joe3501/H520B/结构/2.png

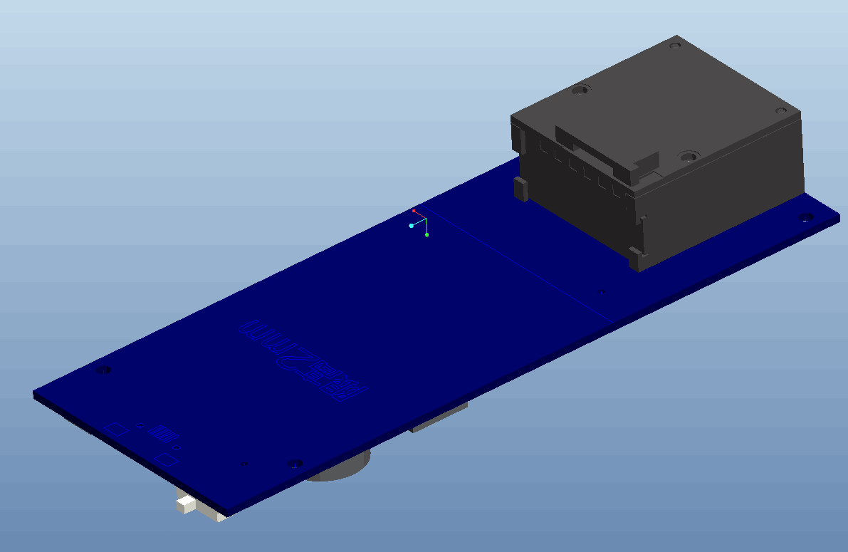
结构/2.png
