joe3501/H520B/结构/1.png

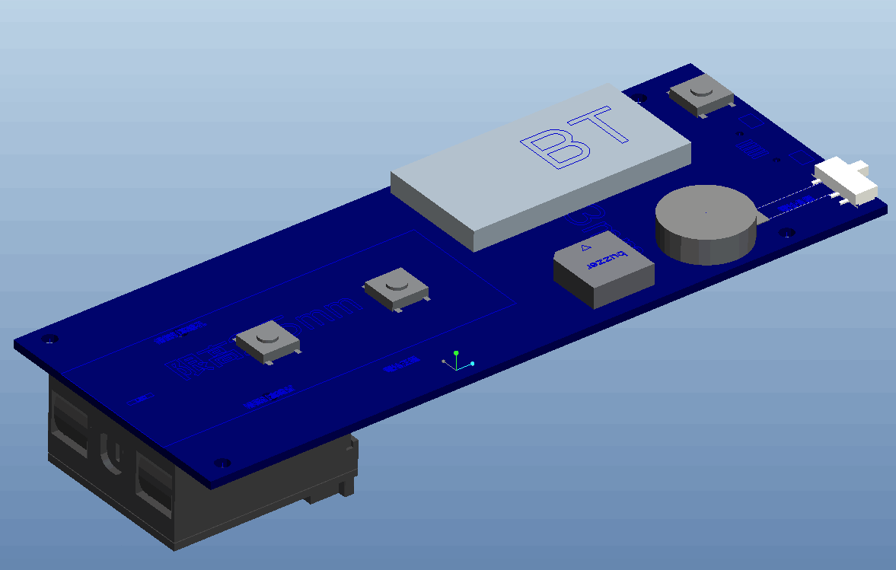
结构/1.png
