joe3501/H520B/README.md

# H520B
my handy blue tooth 1D  barcode scanner project

this project include all the data about hw、fw、结构、doc for the H520B.
