joe3501/H520B/结构/BT-PCB-151204/bt-pcb-hj5000_M3-151204.pdf

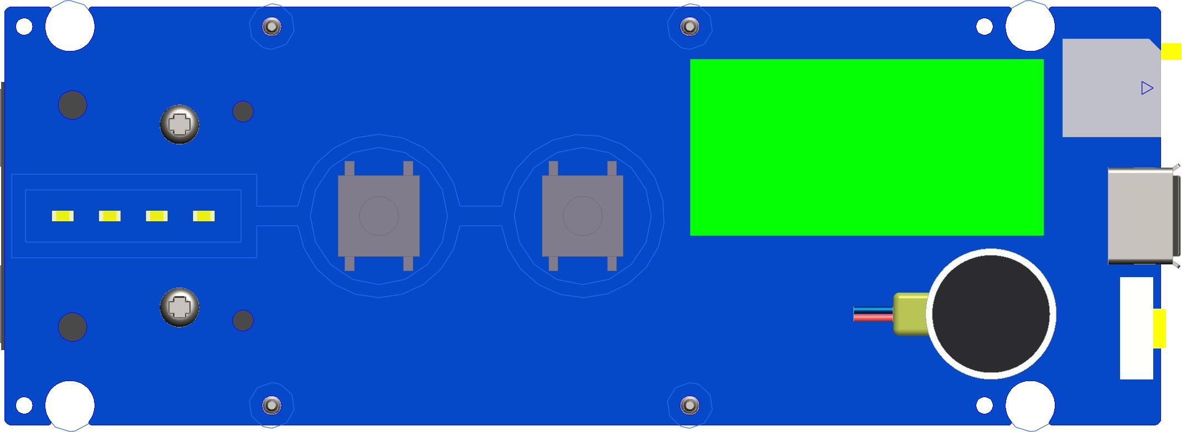
[picture p4: figure]
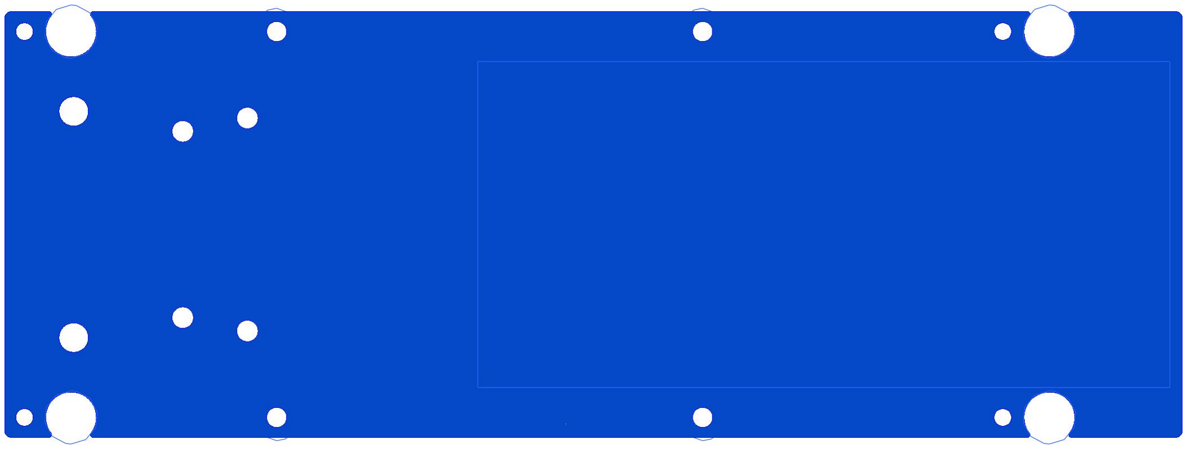
[picture p5: figure]

比例 1,000

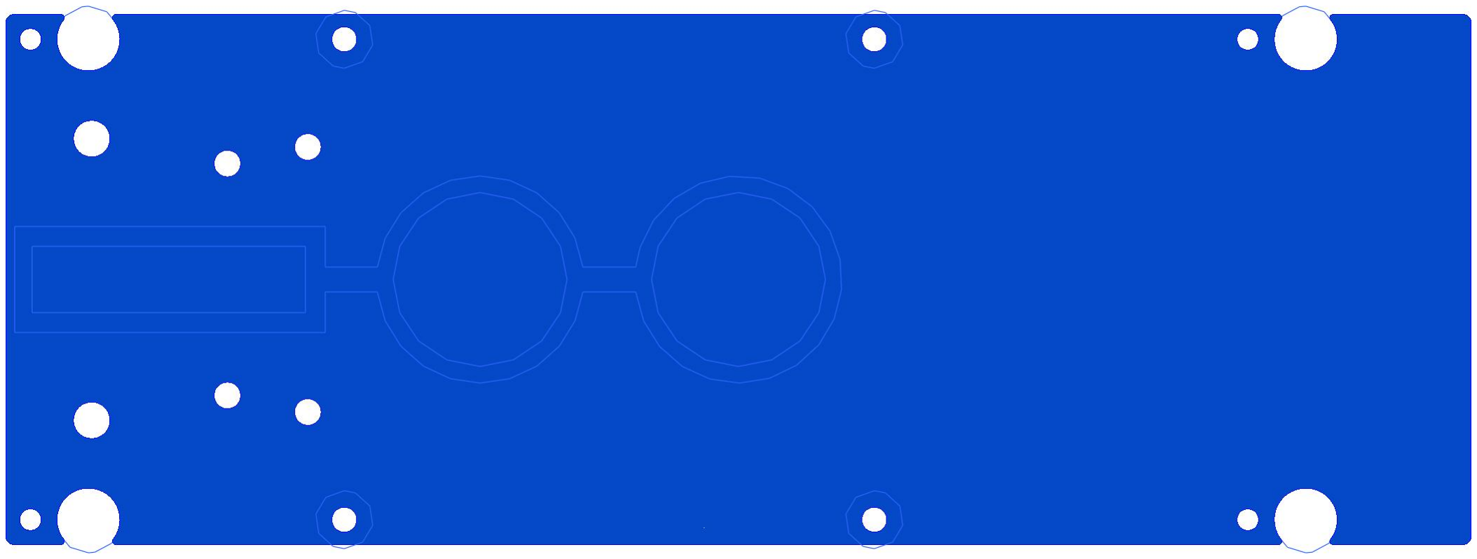
[picture p6: figure]
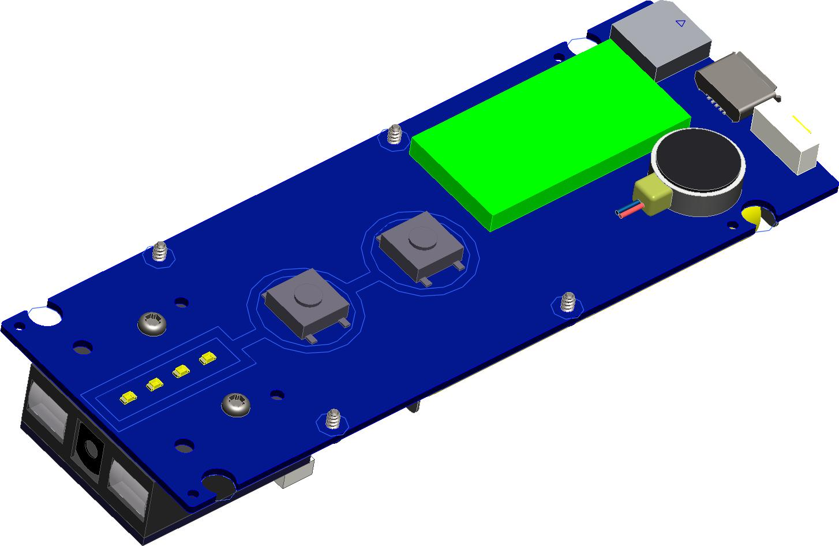
[picture p7: figure]
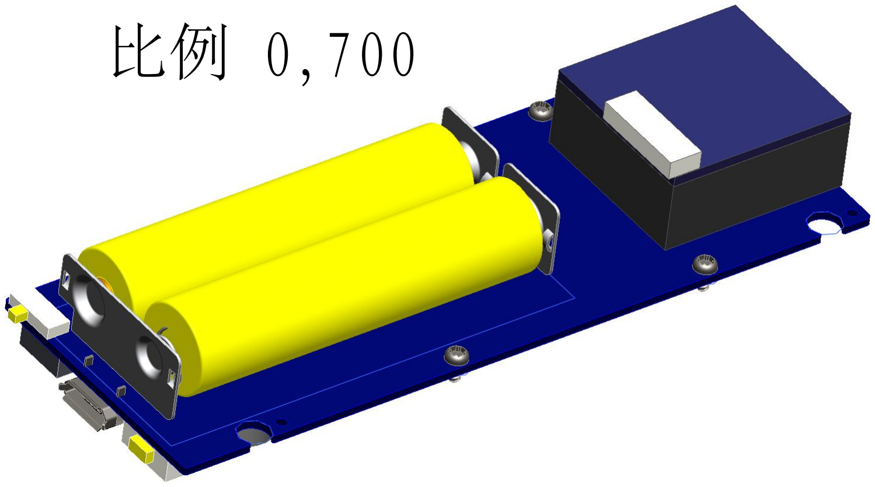
[picture p8: figure]

比例 0,700

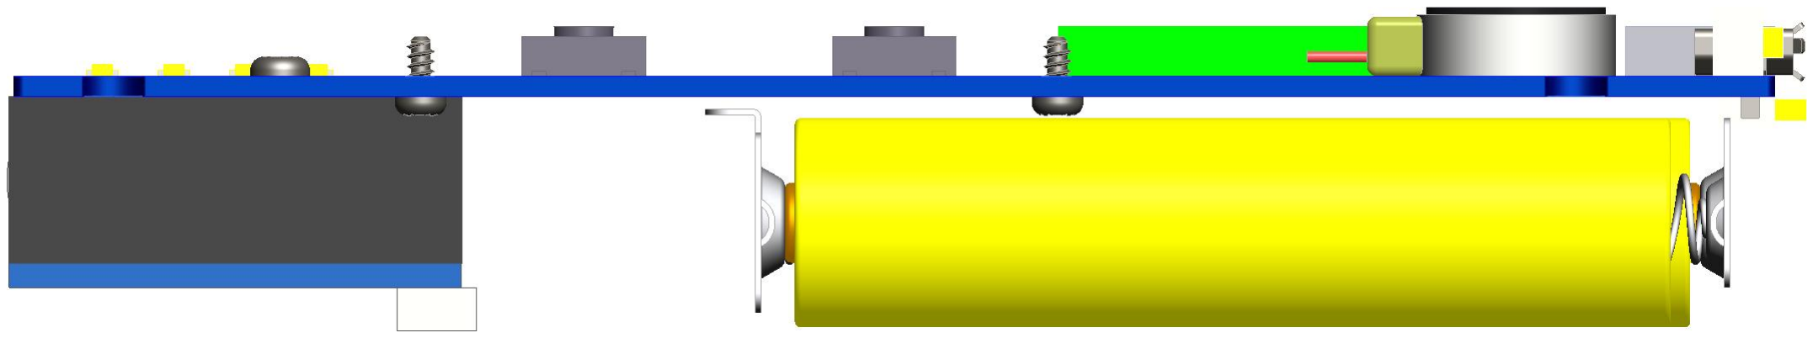
[picture p9: figure]
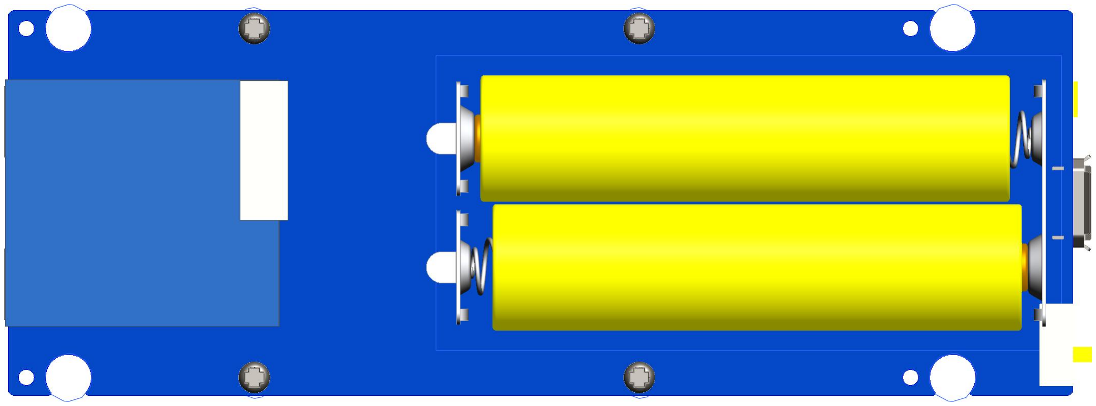
[picture p10: figure]
