joe3501/H520B/结构/BT-PCB-151204/bt-pcb-M2-151204.pdf

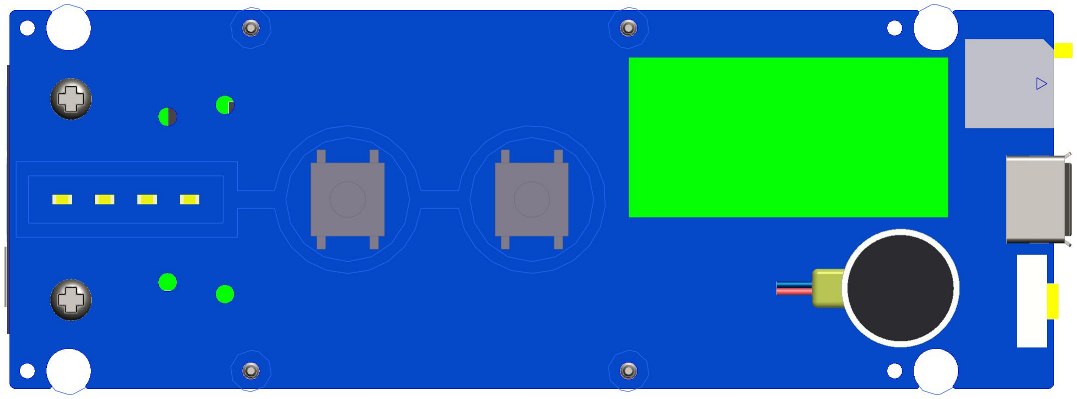
[picture p11: figure]

比例 1,000

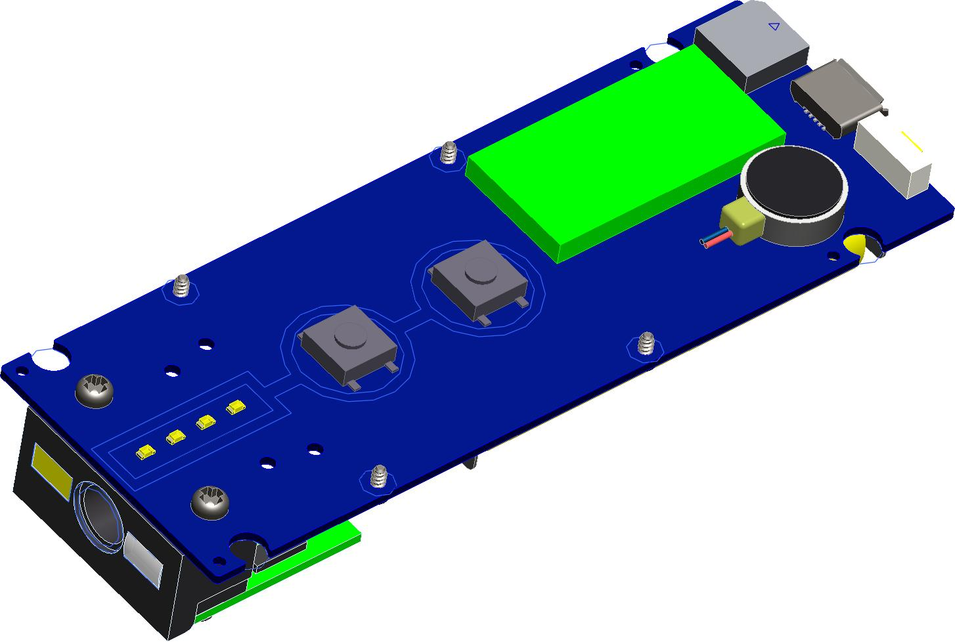
[picture p12: figure]
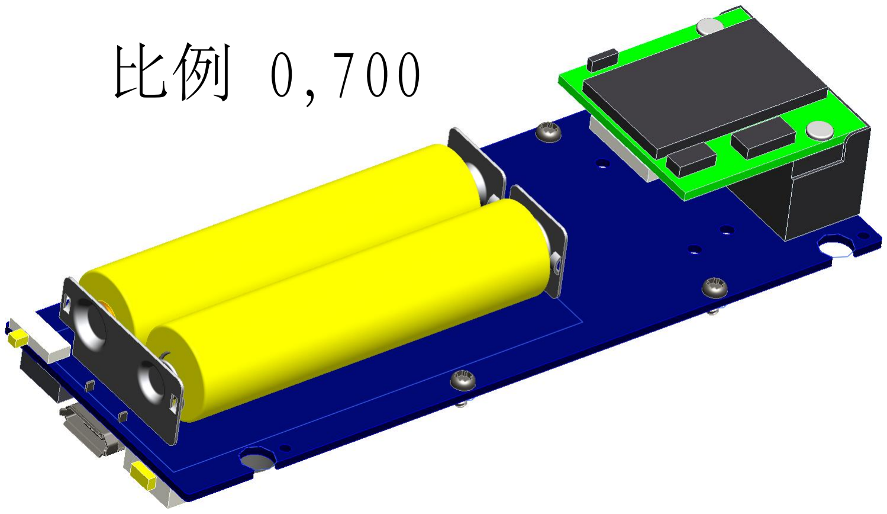
[picture p13: figure]

比例 0,700

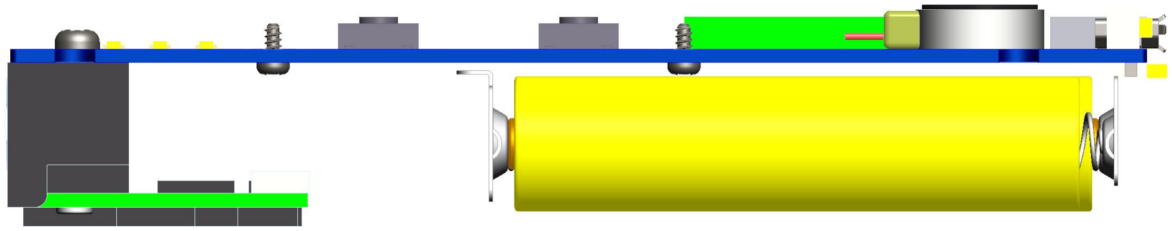
[picture p14: figure]
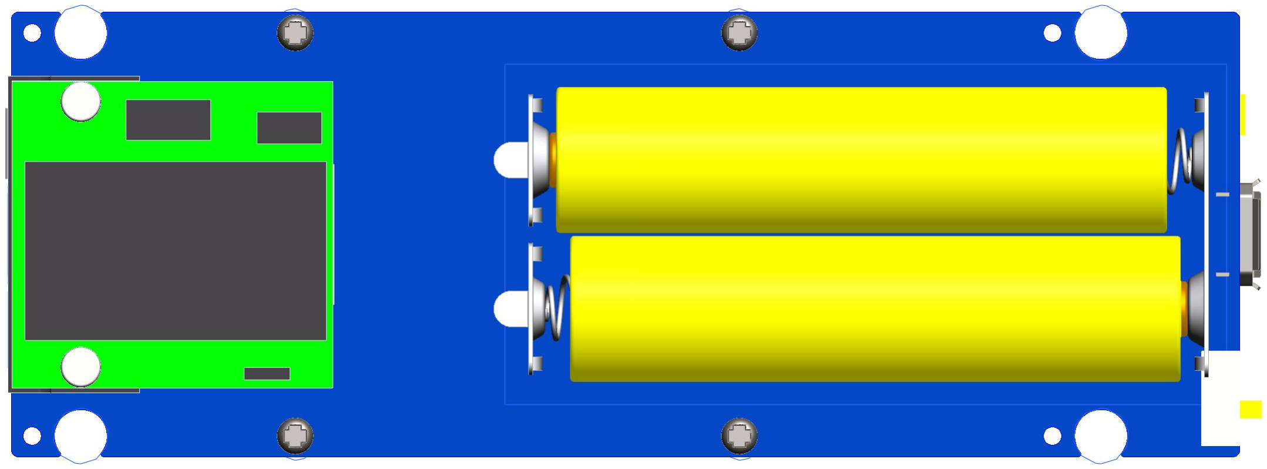
[picture p15: figure]
