joe3501/H520B/结构/BT-PCB-151204/bt-PCB-ZP-151104.pdf

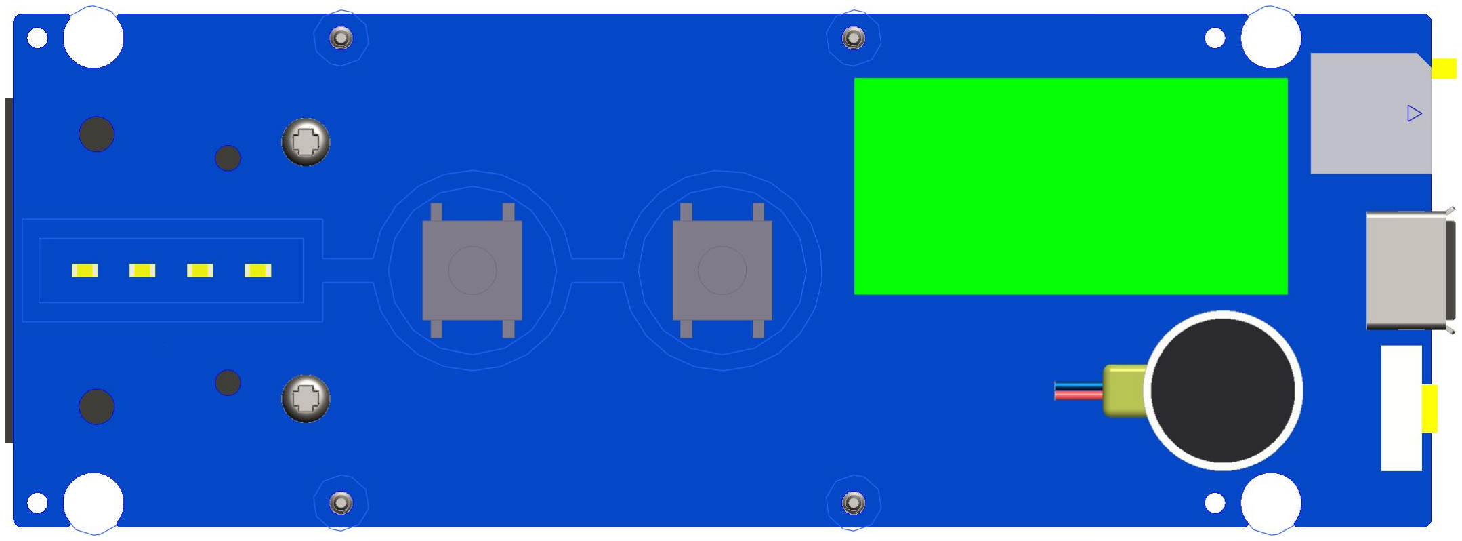
[picture p16: figure]

比例 1,000

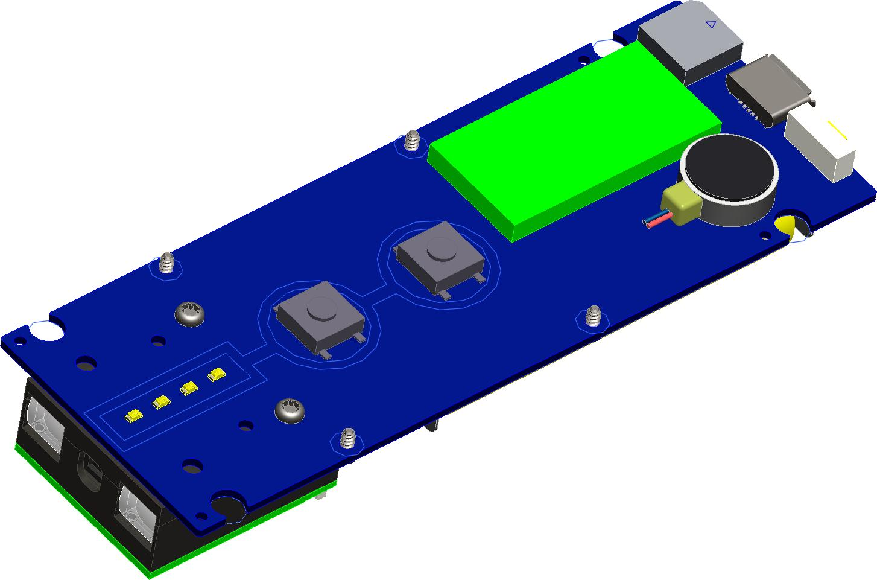
[picture p17: figure]
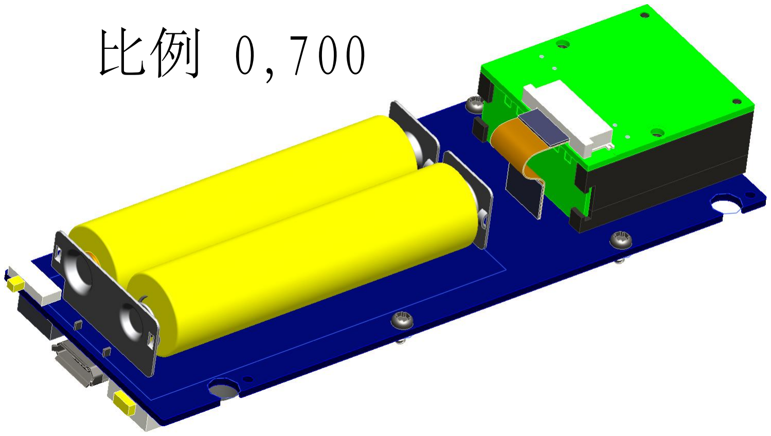
[picture p18: figure]

比例 0,700

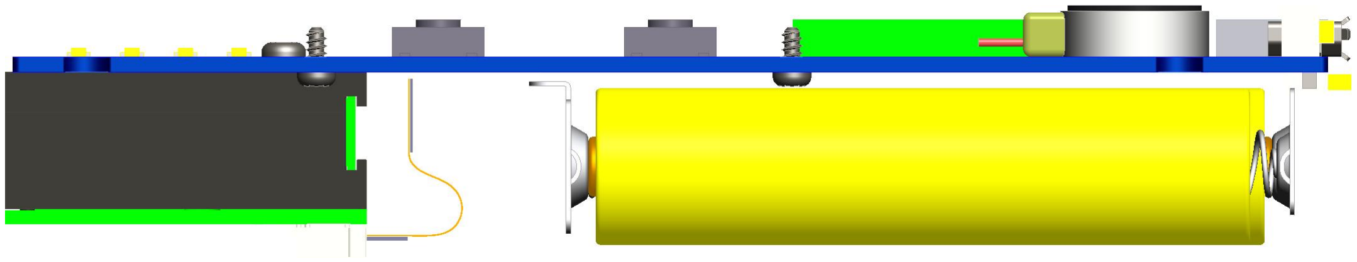
[picture p19: figure]
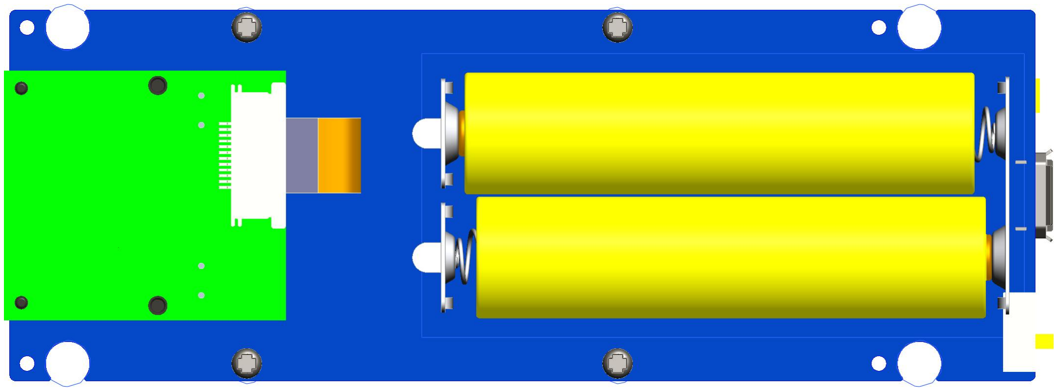
[picture p20: figure]
