joe3501/H520B/HW/data/MCBF-5S-H-R0TL4(MICRO USB).pdf

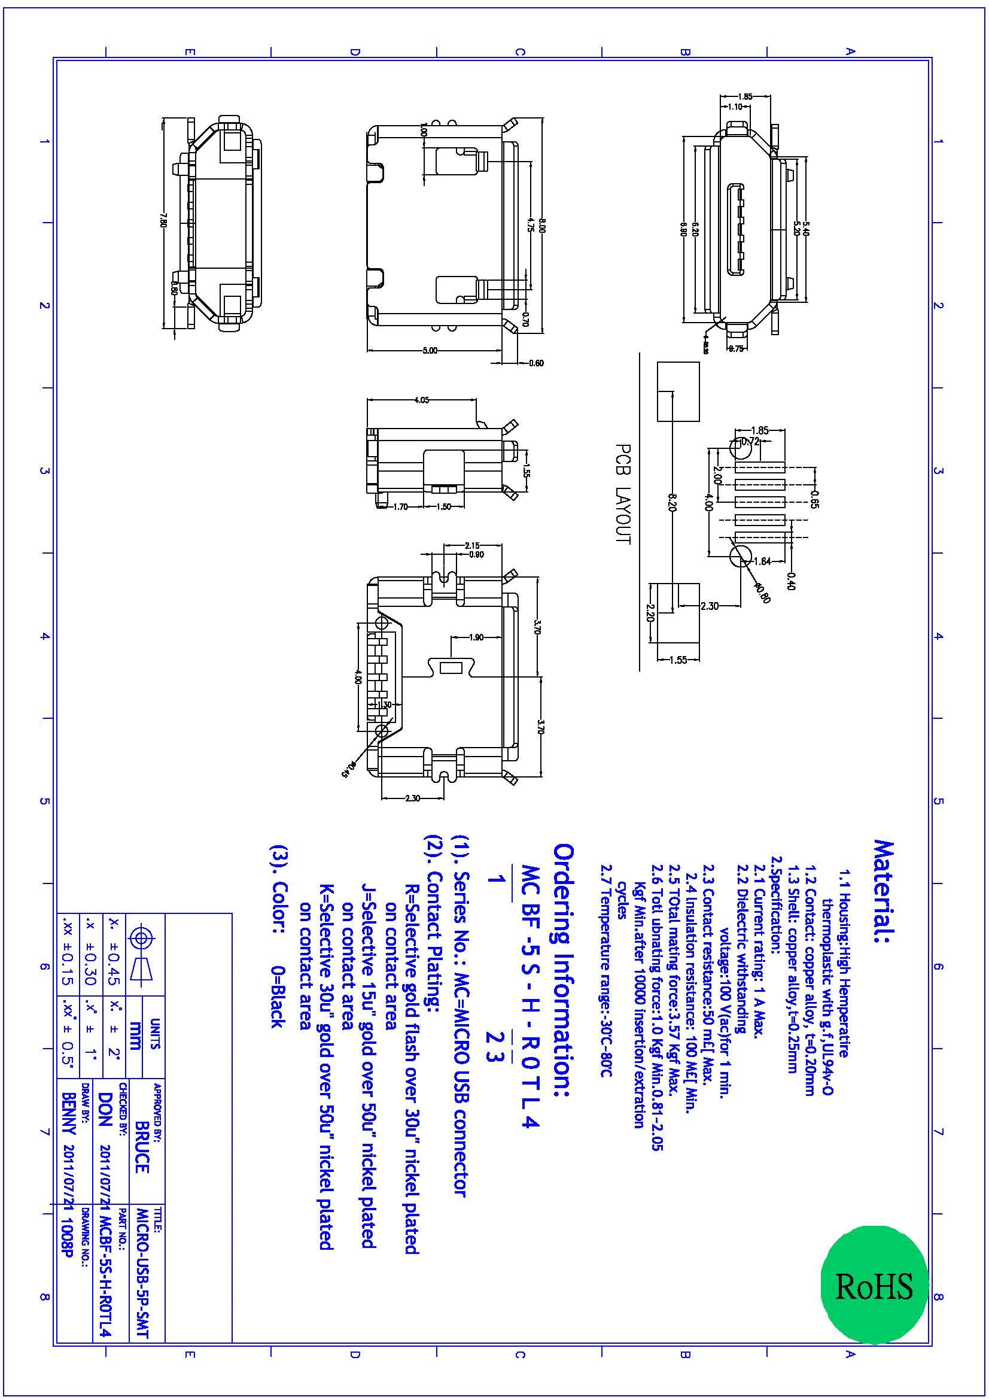
[picture p21: page 1]
