joe3501/H520B/HW/data/七脚拔动.pdf

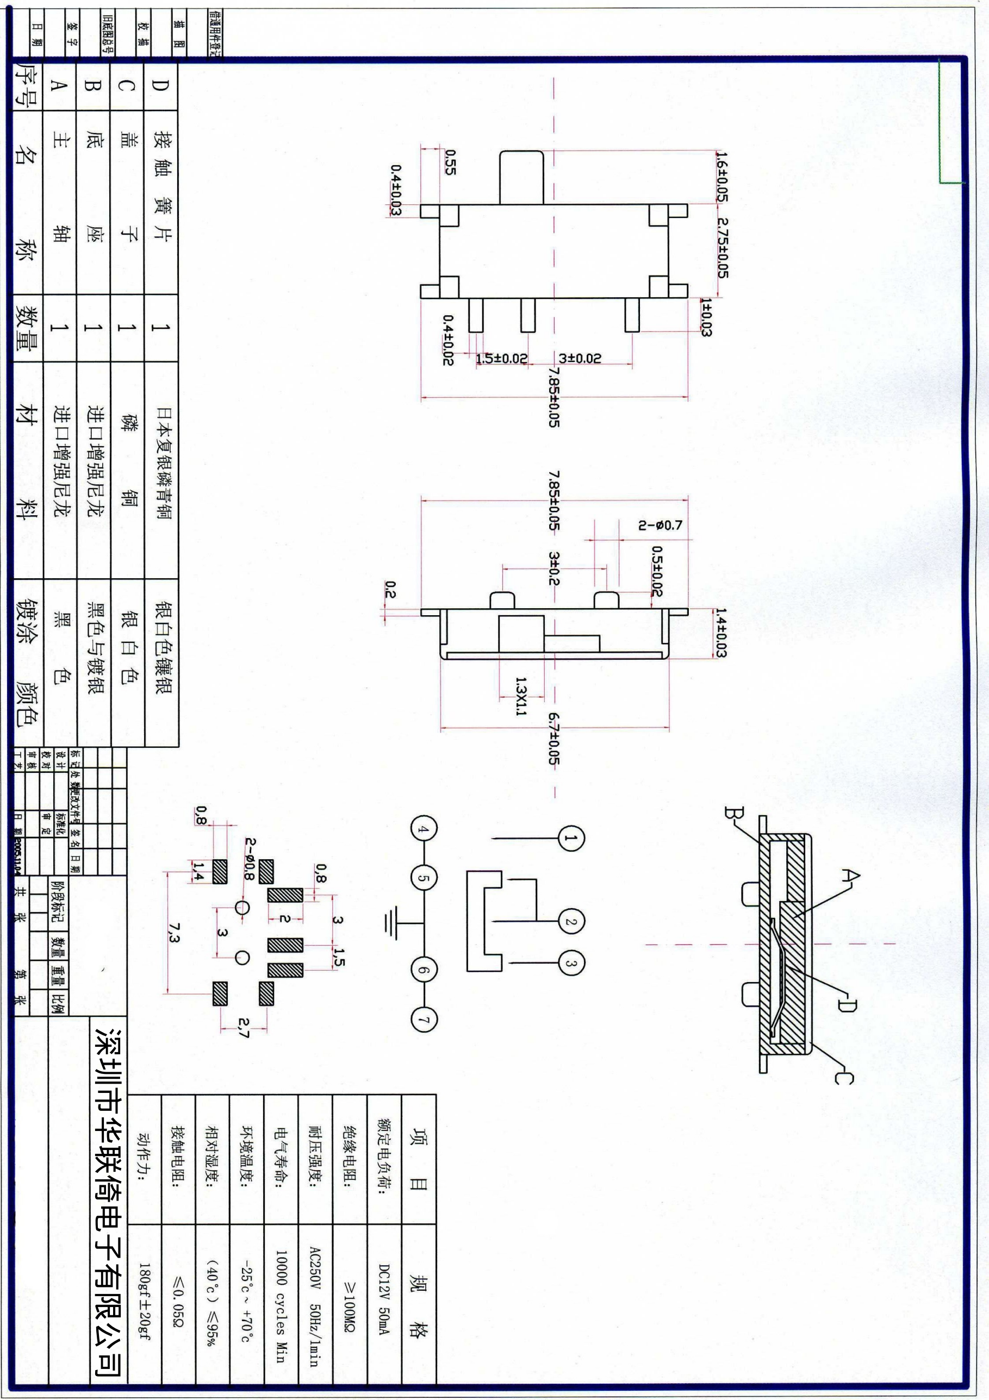
[picture p22: page 1]

深圳市华联倚电子有限公司

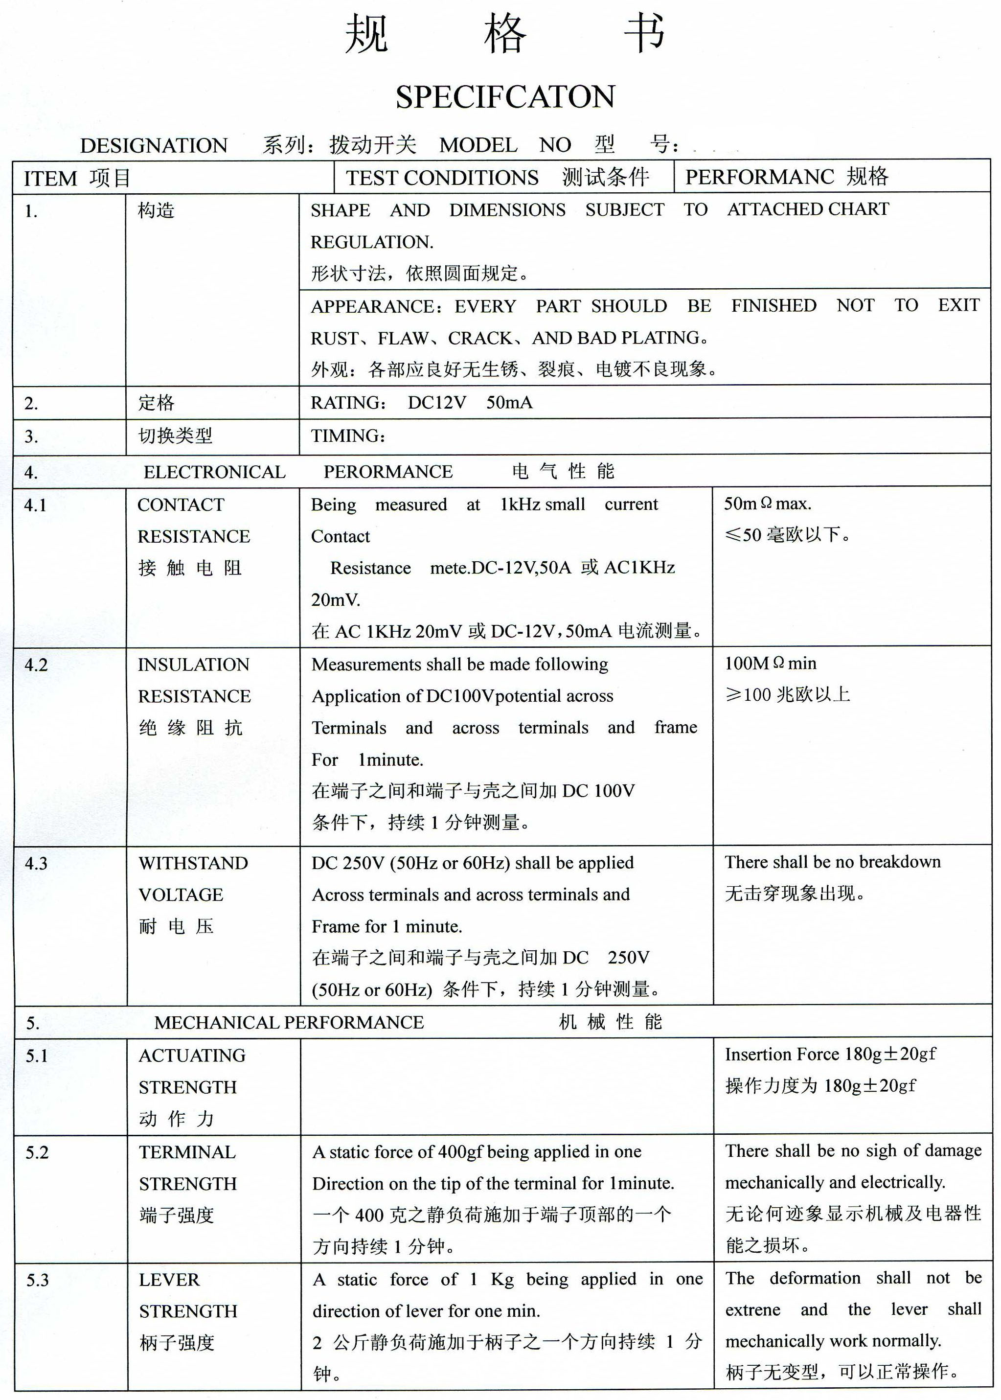
[picture p23: page 2]
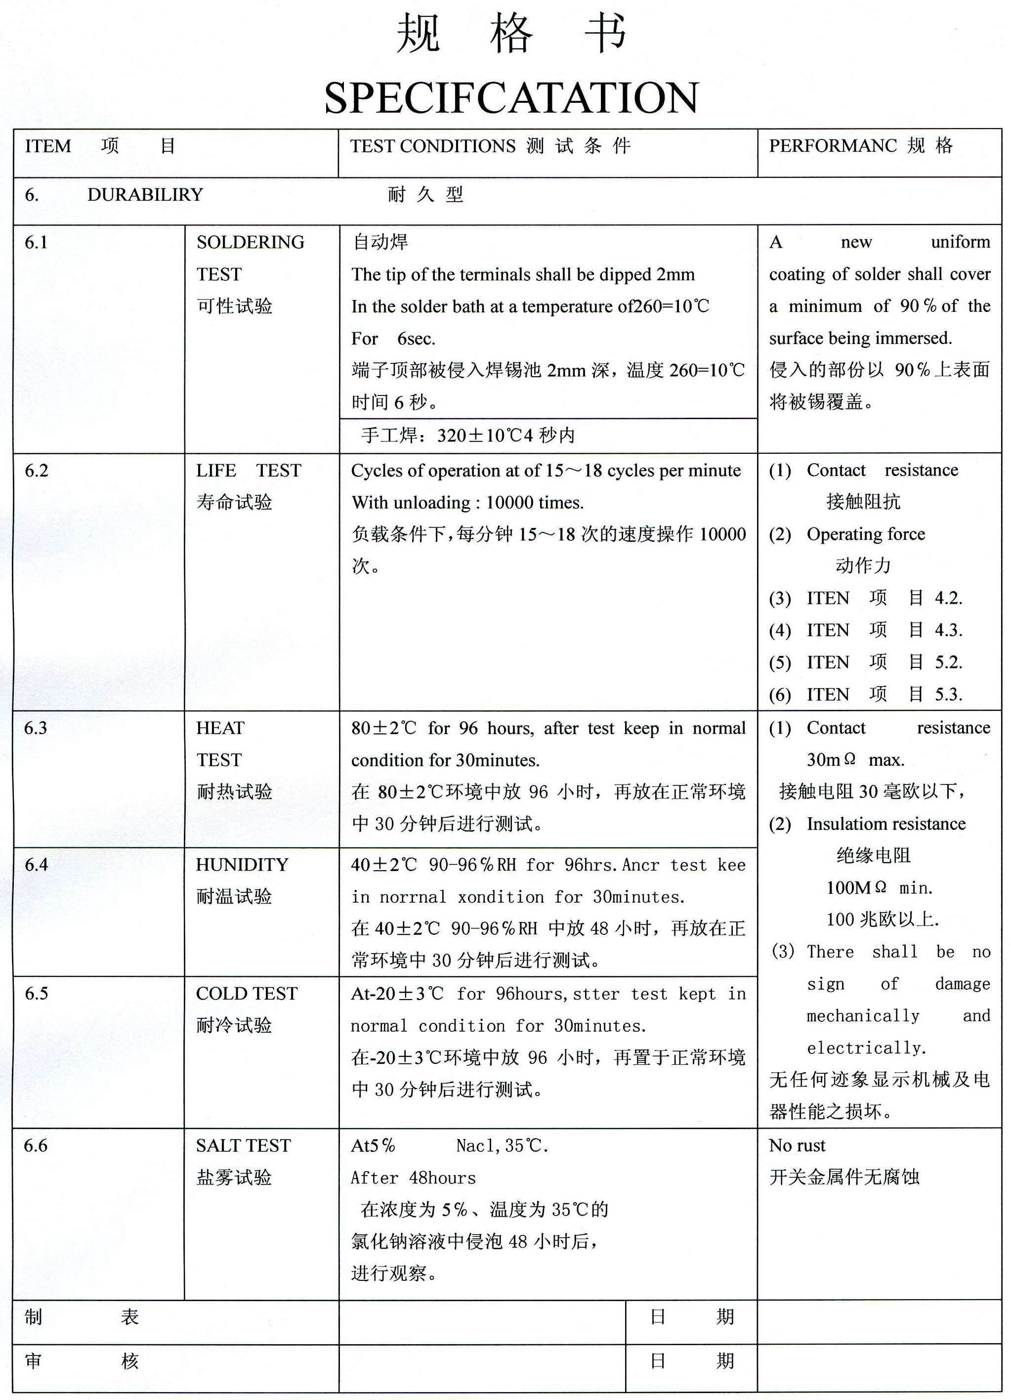
[picture p24: page 3]
