joe3501/H520B/HW/H520B Demoboard V1.0 BOM.xlsx

Part Report (BaseOption) for H520B V1.00.pcb on 2015/9/9 11:21:29
Index | Description | Value | Decal | QTY | Name
Chips |  |  |  | 6
1 | MX25L6445EM2-10G | SPI Flash | SO-8-320MIL | 1 | U3
2 | 贴片蓝牙模块 | 蓝牙模块 | WBTDS01 | 1 | U2
3 | LM324 | LM324 | SO14 | 1 | U13
4 | LS2533A | LS2533A | SOP8 | 1 | U10
5 | STM32F103C8T6 | STM32F103C8T6 | LQFP48 | 1 | U1
6 | SY7109 | SY7109 | SOT23-6 | 1 | U7
Resisters |  |  |  | 34
7 | 0mR | 0R | R0402 | 6 | R1 R8 R9 R25 R33 R36
8 | 33R | 33R | R0402 | 4 | R2 R23 R24 R31
9 | 100R | 100R | R0402 | 1 | R7
10 | 1KR | 1K | R0402 | 3 | R5 R27 R32
11 | 1.5KR | 1.5K | R0402 | 1 | R12
12 | 2.7KR | 2.7K | R0402 | 1 | R16
13 | 10KR | 10K | R0402 | 10 | R3 R4 R6 R10 R28 R29 R30 R34 R35 R39
14 | 30KR | 30K | R0402 | 1 | R11
15 | 47KR | 47K | R0402 | 2 | R19 R26
16 | 100KR | 100K | R0402 | 1 | R17
17 | 150KR | 150K | R0402 | 1 | R15
18 | 1MR | 1M | R0402 | 2 | R13 R22
19 | 2MR | 2M | R0402 | 1 | R14
Capacitors |  |  |  | 24
20 | 20pF | 20p | C0402 | 2 | C2 C19
21 | 10nF | 10nF | C0402 | 1 | C55
22 | 100nF | 0.1uF | C0402 | 7 | C17 C22 C23 C25 C42 C49 C53
23 | 100nF/10V | 0.1uF/10V | C0402 | 1 | C9
24 | 1uF | 1uF | C0402 | 3 | C3 C4 C26
25 | 1uF/10V | 1uF/10V | C0402 | 1 | C54
26 | 4.7uF | 4.7uF | C0402 | 3 | C1 C5 C21
27 | 10uF | 10uF | C0805 | 1 | C24
28 | 10uF/10V | 10uF/10V | C0805 | 2 | C8 C52
30 | 22uF/10V | 22uF/10V | C3528 | 2 | CT6 C48
31 | 47uF/10V(Tan) | 47uF/10V(Tan) | C3528 | 1 | CT3
Inductors |  |  |  | 1
32 | 4.7UH | 4.7uH | SMD_L_4X4 | 1 | L5
Diodes |  |  |  | 7
33 | 1N5819 | 1N5819 | D0603A | 3 | D1 D14 D15
34 | Blue | Blue | LED0603 | 1 | LED2
35 | Green | Green | LED0603 | 1 | LED3
36 | Red | Red | LED0603 | 1 | LED1
37 | Yellow | Yellow | LED0603 | 1 | LED4
Triodes |  |  |  | 4
38 | 3904 | 3904 | SOT23 | 3 | Q1 Q2 Q3
39 | IR6402 | IR6402 | SOT23 | 1 | Q8
Crystals |  |  |  | 1
40 | 12MHZ | 12MHZ | HSX321S-1 | 1 | Y2
Connectors |  |  |  | 9
45 | USB | USB | MICROUSB_H520B | 1 | J3
Switchs |  |  |  | 4
46 | 6脚拨动开关 | 6脚拨动开关 | 3PIN_SWITCH | 1 | SW1
47 | 轻触开关 | 轻触开关 | KEY_H520B | 3 | SW2 SW3 SW4
Unkowns |  |  |  | 6
50 | 10R 1W | 10R 1W | R0805 | 1 | R18
51 | 20K 1% | 20K 1% | R0402 | 1 | R38
52 | 30k 1% | 30k 1% | R0402 | 2 | R20 R21
53 | 91k 1% | 91k 1% | R0402 | 1 | R37
54 | 无源蜂鸣器 3.3V | 无源蜂鸣器 | BEEPER-9.0-4.0 | 1 | BEEP2
Design Part Count: 96
