joe3501/H520B/(list of files, cad)

Other CAD files:
结构/bt-PCB-150822.dwg
结构/BT-PCB-151204/bt-pcb-hj5000_M3-151204.dwg
结构/bt-PCB-150817.dwg
结构/BT-PCB-151204/bt-pcb-M2-151204.dwg
结构/bt-PCB-150803.dwg
结构/BT-PCB-151204/bt-PCB-ZP-151104.dwg
结构/bt-PCB-150821.dwg
