joe3501/H520B/HW/h520b_v100.pdf

## WBTDS01

## CON12

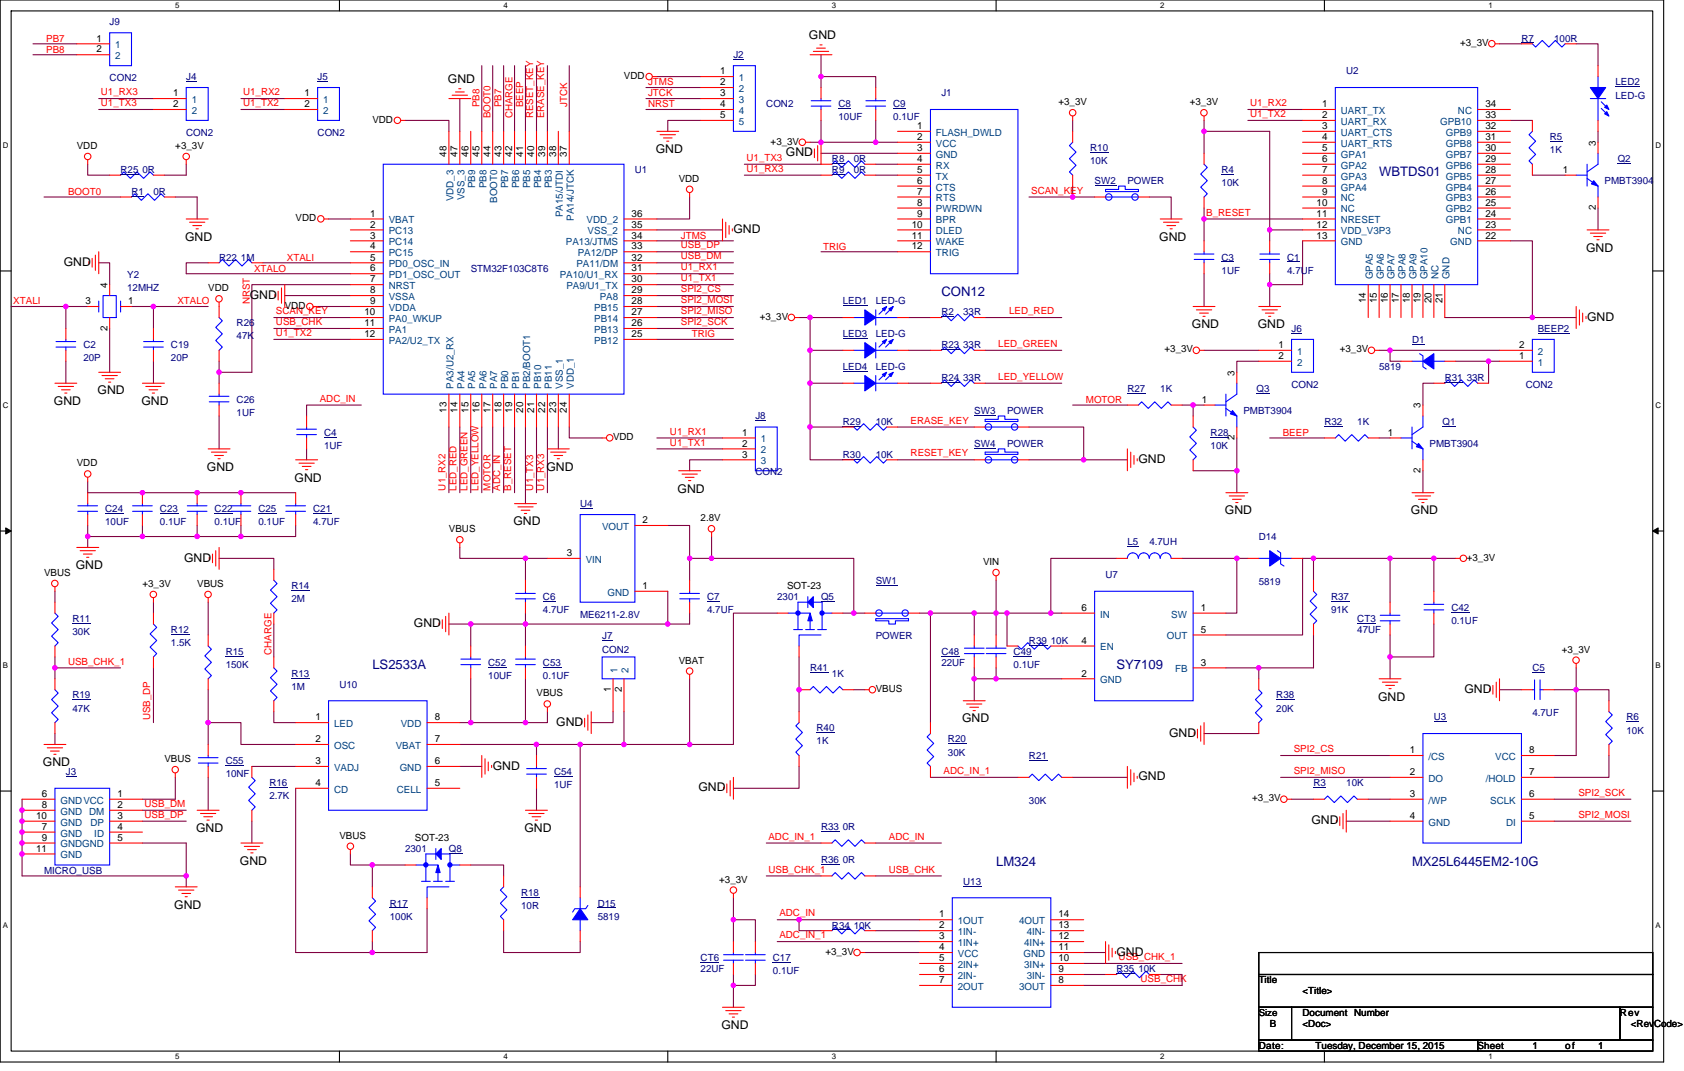
[picture p25: page 1]

Size Size Size B B B | Document Number Document Number Document Number | Rev Rev Rev

Date: Date: Date: Tuesday, December 15, 2015 Tuesday, December 15, 2015 Tuesday, December 15, 2015 | Sheet Sheet Sheet 1 1 1 of of of 1 1 1
