joe3501/H520B/HW/top-silkscreen.pdf

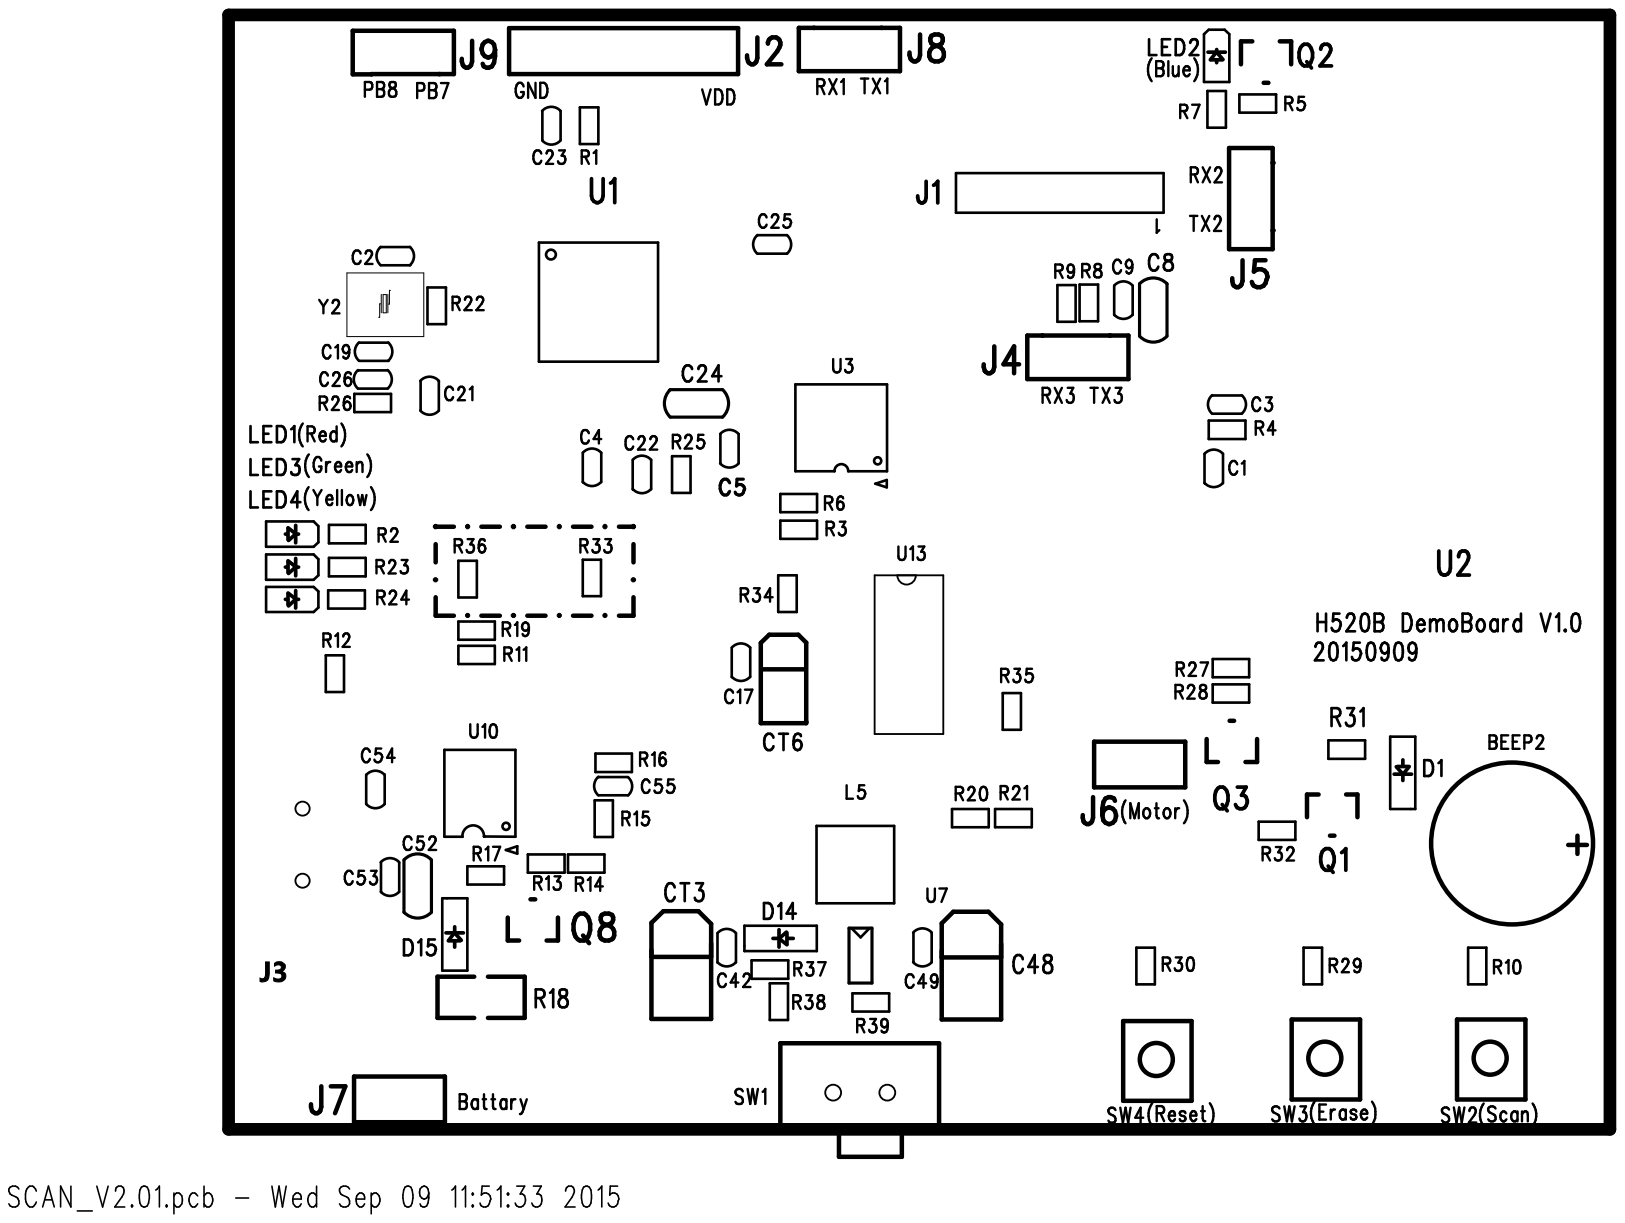
[picture p26: page 1]
