joe3501/H520B/HW/data/IT-1127-160G-G(tact sw).pdf

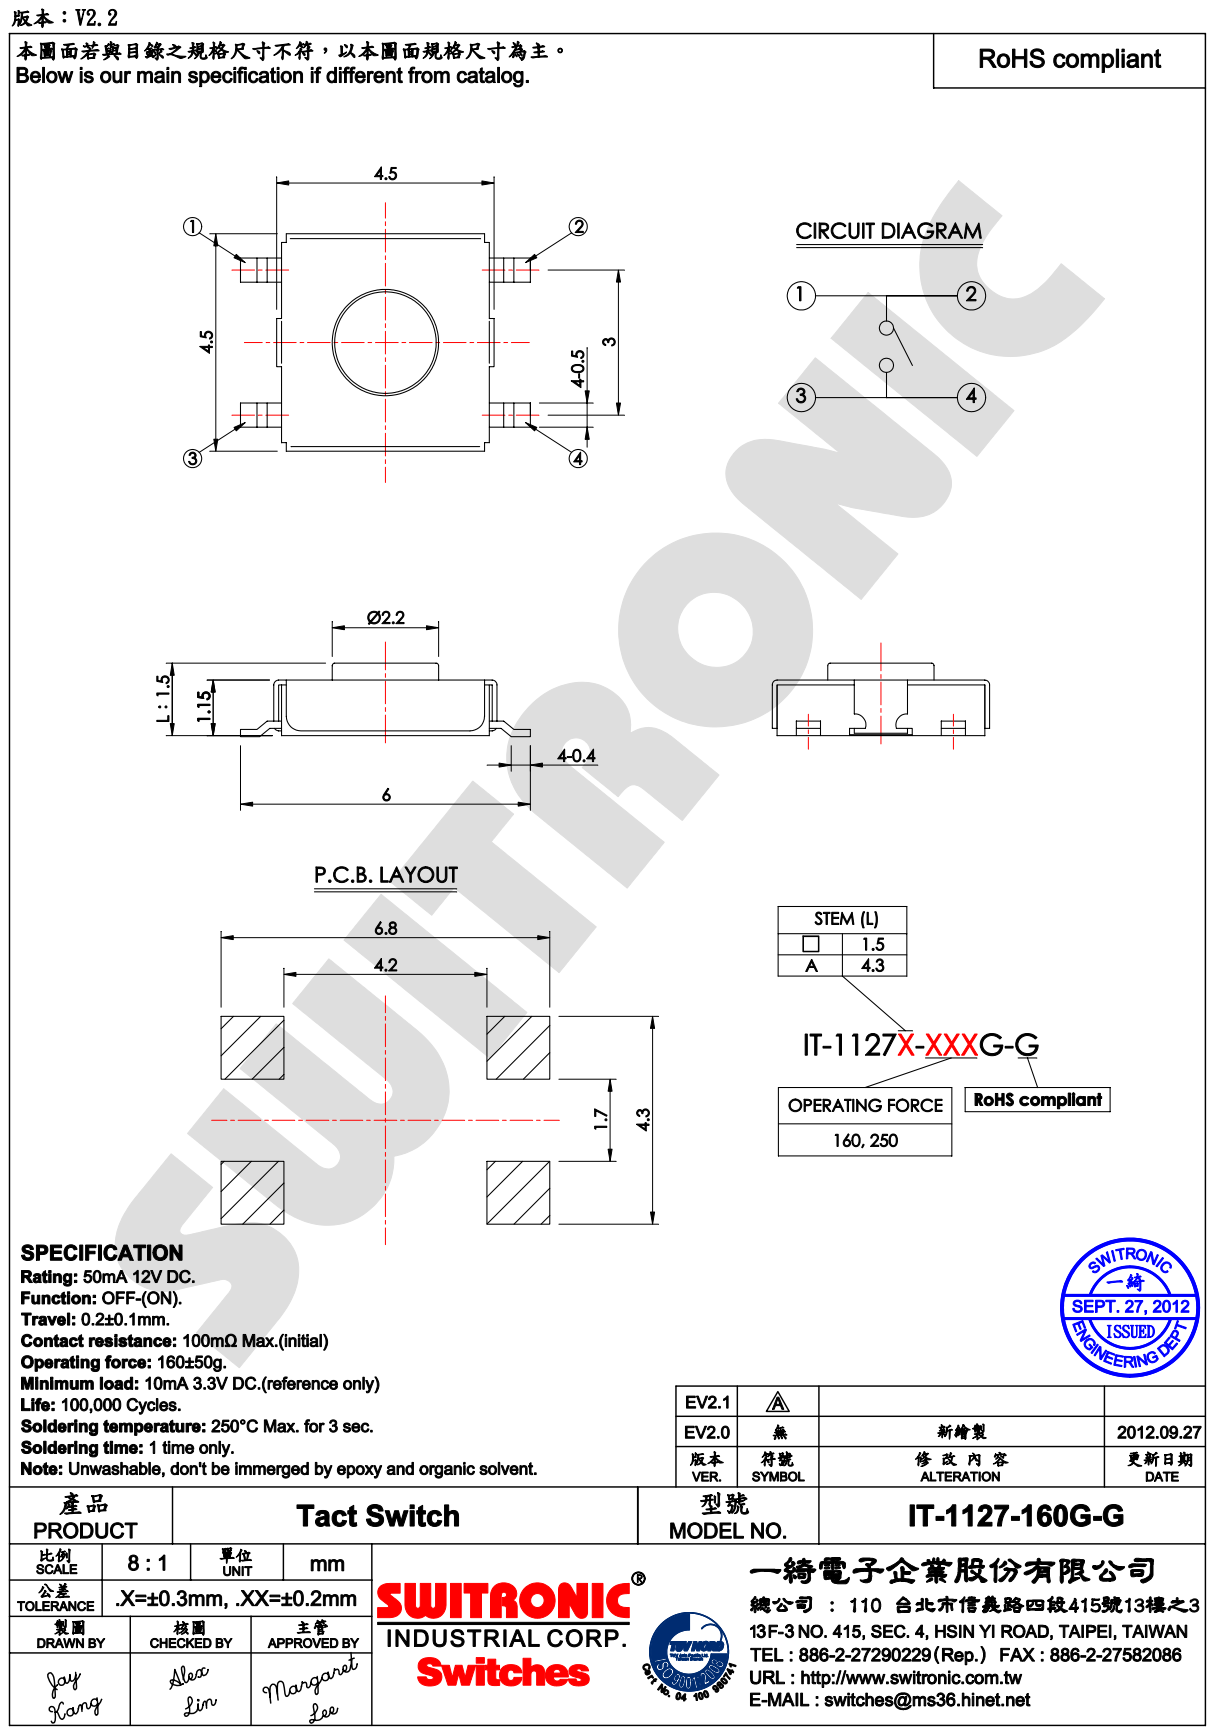
[picture p27: page 1]
