joe3501/H520B/(list of files, drawings)

Other design files:
HW/H520B V1.00.pcb
HW/H520B_V100.pcb
