joe3501/H520B/FW/src/Drivers/hw_platform.c

/**
* @file hw_platform.c
* @brief H520B 硬件相关接口的实现
* @version V0.0.1
* @author joe.zhou
* @date 2015年08月31日
* @note
* @copy
*
* 此代码为深圳合杰电子有限公司项目代码，任何人及公司未经许可不得复制传播，或用于
* 本公司以外的项目。本司保留一切追究权利。
*
* <h1><center>&copy; COPYRIGHT 2015 heroje</center></h1>
*
*/
#include "hw_platform.h"
#include "stm32f10x_lib.h"
#include "ucos_ii.h"
#include "TimeBase.h"
#include <assert.h>

static unsigned int	charge_state_cnt;
static unsigned int	last_charge_detect_io_cnt;

unsigned int	charge_detect_io_cnt;

static unsigned char	current_led_state;
static VTIMER_HANDLE	led_timer_h[4];

#define		LED_RED_MASK			(0x01<<0)
#define		LED_GREEN_MASK			(0x01<<1)
#define		LED_YELLOW_MASK			(0x01<<2)
#define		LED_BLUE_MASK			(0x01<<3)

#define		LED_RED_ON_MASK			(0x01<<4)
#define		LED_GREEN_ON_MASK		(0x01<<5)
#define		LED_YELLOW_ON_MASK		(0x01<<6)
#define		LED_BLUE_ON_MASK		(0x01<<7)

//USB_CHK		PA1	  

//LED_RED		PA4   
//LED_GREEN		PA5   
//LED_YELLOW	PA6   
//MOTOR			PA7   

//ADC_IN		PB0	  

//BEEP			PB5   
//CHARGE		PB6	  
//RFU_IO1		PB7
//RFU_IO2		PB8

//TRIG			PB12

/**
* @brief	初始化用于电池电压检测的ADC模块
* @param[in]  none
* @param[out] none
* @return     none
* @note                    
*/
static void ADC_Module_Init(void)
{
	ADC_InitTypeDef   adc_init;
	GPIO_InitTypeDef  gpio_init;


	RCC_APB2PeriphClockCmd(RCC_APB2Periph_ADC1, ENABLE);
	RCC_APB2PeriphClockCmd(RCC_APB2Periph_GPIOB, ENABLE);

	//PB.0   ADC-IN
	gpio_init.GPIO_Pin  = GPIO_Pin_0;
	gpio_init.GPIO_Speed = GPIO_Speed_50MHz;
	gpio_init.GPIO_Mode = GPIO_Mode_AIN;
	GPIO_Init(GPIOB, &gpio_init);

	adc_init.ADC_Mode               = ADC_Mode_Independent;		//
	adc_init.ADC_ScanConvMode       = DISABLE;
	adc_init.ADC_ContinuousConvMode = ENABLE;
	adc_init.ADC_ExternalTrigConv   = ADC_ExternalTrigConv_None;
	adc_init.ADC_DataAlign          = ADC_DataAlign_Right;
	adc_init.ADC_NbrOfChannel       = 1;
	ADC_Init(ADC1, &adc_init);

	ADC_RegularChannelConfig(ADC1, ADC_Channel_8, 1, ADC_SampleTime_13Cycles5);
	ADC_Cmd(ADC1, ENABLE);

	// 下面是ADC自动校准，开机后需执行一次，保证精度
	// Enable ADC1 reset calibaration register 
	ADC_ResetCalibration(ADC1);
	// Check the end of ADC1 reset calibration register
	while(ADC_GetResetCalibrationStatus(ADC1));

	// Start ADC1 calibaration
	ADC_StartCalibration(ADC1);
	// Check the end of ADC1 calibration
	while(ADC_GetCalibrationStatus(ADC1));
	// ADC自动校准结束---------------

	ADC_SoftwareStartConvCmd(ADC1, ENABLE);			//开始转换
}

/**
* @brief  Initialize the IO
* @return   none
*/
static void platform_misc_port_init(void)
{
	GPIO_InitTypeDef	GPIO_InitStructure;
	EXTI_InitTypeDef	EXTI_InitStructure;
	NVIC_InitTypeDef	NVIC_InitStructure;

	RCC_APB2PeriphClockCmd(RCC_APB2Periph_GPIOA | RCC_APB2Periph_GPIOB, ENABLE);

	//USB_CHK -- PA.1
	GPIO_InitStructure.GPIO_Pin				= GPIO_Pin_1;
	GPIO_InitStructure.GPIO_Mode			= GPIO_Mode_IN_FLOATING;
	GPIO_InitStructure.GPIO_Speed			= GPIO_Speed_10MHz;
	GPIO_Init(GPIOA, &GPIO_InitStructure);

	/* Connect EXTI Line6 to PB.6 */
	GPIO_EXTILineConfig(GPIO_PortSourceGPIOA, GPIO_PinSource1);

	EXTI_ClearITPendingBit(EXTI_Line1);
	EXTI_InitStructure.EXTI_Line = EXTI_Line1;
	EXTI_InitStructure.EXTI_Mode = EXTI_Mode_Interrupt;
	EXTI_InitStructure.EXTI_Trigger = EXTI_Trigger_Rising_Falling;
	EXTI_InitStructure.EXTI_LineCmd = ENABLE;
	EXTI_Init(&EXTI_InitStructure); 
	EXTI_GenerateSWInterrupt(EXTI_Line1);

	NVIC_PriorityGroupConfig(NVIC_PriorityGroup_1);      
	NVIC_InitStructure.NVIC_IRQChannel = EXTI1_IRQChannel;
	NVIC_InitStructure.NVIC_IRQChannelPreemptionPriority = 1;
	NVIC_InitStructure.NVIC_IRQChannelSubPriority = 6;
	NVIC_InitStructure.NVIC_IRQChannelCmd = ENABLE;
	NVIC_Init(&NVIC_InitStructure);

	//ChargeState detect -- PB.6
	GPIO_InitStructure.GPIO_Pin  = GPIO_Pin_6;
	GPIO_InitStructure.GPIO_Speed = GPIO_Speed_10MHz;
	GPIO_InitStructure.GPIO_Mode = GPIO_Mode_IN_FLOATING;
	GPIO_Init(GPIOB, &GPIO_InitStructure);

	/* Connect EXTI Line6 to PB.6 */
	GPIO_EXTILineConfig(GPIO_PortSourceGPIOE, GPIO_PinSource0);

	EXTI_ClearITPendingBit(EXTI_Line6);
	EXTI_InitStructure.EXTI_Line = EXTI_Line6;
	EXTI_InitStructure.EXTI_Mode = EXTI_Mode_Interrupt;
	EXTI_InitStructure.EXTI_Trigger = EXTI_Trigger_Rising_Falling;
	EXTI_InitStructure.EXTI_LineCmd = ENABLE;
	EXTI_Init(&EXTI_InitStructure); 
	EXTI_GenerateSWInterrupt(EXTI_Line6);

	NVIC_PriorityGroupConfig(NVIC_PriorityGroup_1);      
	NVIC_InitStructure.NVIC_IRQChannel = EXTI9_5_IRQChannel;
	NVIC_InitStructure.NVIC_IRQChannelPreemptionPriority = 1;
	NVIC_InitStructure.NVIC_IRQChannelSubPriority = 6;
	NVIC_InitStructure.NVIC_IRQChannelCmd = ENABLE;
	NVIC_Init(&NVIC_InitStructure);

	charge_detect_io_cnt = 0;
	last_charge_detect_io_cnt = 1;

	//LED-Red -- PA.4	LED-Green -- PA.5	LED-Yellow -- PA.6		Motor -- PA.7
	GPIO_InitStructure.GPIO_Pin	= GPIO_Pin_4 | GPIO_Pin_5 | GPIO_Pin_6 | GPIO_Pin_7;
	GPIO_InitStructure.GPIO_Mode = GPIO_Mode_Out_PP;
	GPIO_InitStructure.GPIO_Speed = GPIO_Speed_10MHz;
	GPIO_Init(GPIOA, &GPIO_InitStructure);
	GPIO_SetBits(GPIOA, GPIO_Pin_4 | GPIO_Pin_5 | GPIO_Pin_6);
	GPIO_ResetBits(GPIOA, GPIO_Pin_7);

	//Beep -- PB.5	LED-Blue -- PB.7
	GPIO_InitStructure.GPIO_Pin	= GPIO_Pin_5 | GPIO_Pin_7;
	GPIO_InitStructure.GPIO_Mode = GPIO_Mode_Out_PP;
	GPIO_InitStructure.GPIO_Speed = GPIO_Speed_10MHz;
	GPIO_Init(GPIOB, &GPIO_InitStructure);
	GPIO_SetBits(GPIOB,  GPIO_Pin_7);
	GPIO_ResetBits(GPIOB, GPIO_Pin_5);

	//RFU-IO2 -- PB.8		
	//GPIO_InitStructure.GPIO_Pin	= GPIO_Pin_8;
	//GPIO_InitStructure.GPIO_Mode = GPIO_Mode_IN_FLOATING;
	//GPIO_Init(GPIOB, &GPIO_InitStructure);
}

/**
* @brief  Initialize the HW platform
* @return   none
*/
void hw_platform_init(void)
{
	platform_misc_port_init();
	ADC_Module_Init();
	current_led_state = 0;
}


/**
* @brief	返回检测到的电压的级别
* @param[in]  none
* @param[out] none
* @return     0:电池电量低		1：还有电
*@note 由于电池电压经过一个MOS管Q5之后，再50%分压进入AD，而MOS管实测大概有0.375V的压降，所以当电池处于低电压阀值2.0（每节1.00V）时，实际
*		AD点的的阀值电压为1.625V/2 = 0.8125V ==>对应的AD值阀值为：1008
*/

#define  LOW_POWER_TH	1008		//	
unsigned int hw_platform_get_PowerClass(void)
{ 
#if 1
	unsigned int  i,result = 0;
	unsigned short  temp[20];
	unsigned short	min,max;

	for(i = 0;i < 20;i++)
	{
		temp[i] = ADC_GetConversionValue(ADC1);		//得到AD转换的结果
		result += temp[i];
		if (i == 0)
		{
			min = temp[i];
			max = temp[i];
		}

		if (temp[i] < min)
		{
			min = temp[i];
		}

		if (temp[i] > max)
		{
			max = temp[i];
		}
	}

	//取20次值之后,去掉最小值和最大周，再取平均值，简单的平滑滤波
	result -= min;
	result -= max;
	result /= 18; 

	if (result > LOW_POWER_TH) 
	{
		return 1;
	}
	else
		return 0;
#endif

	//return 0;
}

/**
* @brief	检测充电状态
* @param[in]  none
* @param[out] none
* @return     1:  充电完成    0: 正在充电
* @note  正在充电时，充电检测IO输出脉冲，充满后输出低电平 
*        需要注意的是：此函数只有在得知充电电源已经插入的前提下，再去检测才有意义。因为没有插入充电电源时，检测IO也是低电平的。
*		利用IO的边沿中断来完成充电状态的检测，如果一直在进中断，那说明正在充电，否则表示充电完成
*/
unsigned int  hw_platform_ChargeState_Detect(void)
{
	if (charge_detect_io_cnt != last_charge_detect_io_cnt)
	{
		charge_state_cnt = 50000;
		last_charge_detect_io_cnt = charge_detect_io_cnt;
		return 0;
	}
	else
	{
		if (charge_state_cnt--)
		{
			return 0;
		}
	}
	return 1;
}

/**
* @brief	检测USB是否插入
* @param[in]  none
* @param[out] none
* @return     1:  插入    0: 没有插入
* @note  如果需要在中断里面去实现，那么还需要在初始化时给此检测IO分配外部中断
*		 如果在任务级查询，那么可以之际调用此函数来检测是否插入充电电源                 
*/
unsigned int hw_platform_USBcable_Insert_Detect(void)
{
	unsigned int i;
	if(GPIO_ReadInputDataBit(GPIOA, GPIO_Pin_1))
	{
		for (i=0;i < 2000;i++);		//延时一小段时间，防止是因为抖动造成的
		if(GPIO_ReadInputDataBit(GPIOA,GPIO_Pin_1))
		{
			return 1;
		}
		else
		{
			return 0;
		}
	}
	else
		return 0;
}

/**
* @brief	LED控制接口
* @param[in]  unsigned int led	 LED_RED or  LED_GREEN  or LED_YELLOW
* @param[in]  unsigned int ctrl  0: close   1:open
* @return   none                 
*/
void hw_platform_led_ctrl(unsigned int led,unsigned int ctrl)
{
	if (led == LED_RED)
	{
		if (ctrl)
		{
			GPIO_ResetBits(GPIOA, GPIO_Pin_4);
		}
		else
		{
			GPIO_SetBits(GPIOA, GPIO_Pin_4);
		}
	}
	else if (led == LED_GREEN)
	{
		if (ctrl)
		{
			GPIO_ResetBits(GPIOA, GPIO_Pin_5);
		}
		else
		{
			GPIO_SetBits(GPIOA, GPIO_Pin_5);
		}
	}
	else if (led == LED_YELLOW)
	{
		if (ctrl)
		{
			GPIO_ResetBits(GPIOA, GPIO_Pin_6);
		}
		else
		{
			GPIO_SetBits(GPIOA, GPIO_Pin_6);
		}
	}
	else if (led == LED_BLUE)
	{
		if (ctrl)
		{
			GPIO_ResetBits(GPIOB, GPIO_Pin_7);
		}
		else
		{
			GPIO_SetBits(GPIOB, GPIO_Pin_7);
		}
	}
}


/**
* @brief	Motor控制接口
* @param[in]  unsigned int delay  延时一段时间,单位ms
* @return   none                 
*/
void hw_platform_motor_ctrl(unsigned short delay)
{
	GPIO_SetBits(GPIOA, GPIO_Pin_7);
	if (delay < 5)
	{
		delay_ms(delay);
	}
	else
	{
		OSTimeDlyHMSM(0,0,0,delay);
	}
	GPIO_ResetBits(GPIOA, GPIO_Pin_7);
}

/**
* @brief	Trig控制接口
* @param[in]  unsigned int delay  延时一段时间,单位ms
* @return   none                 
*/
void hw_platform_trig_ctrl(unsigned short delay)
{
	GPIO_ResetBits(GPIOB, GPIO_Pin_12);
	if (delay < 5)
	{
		delay_ms(delay);
	}
	else
	{
		OSTimeDlyHMSM(0,0,0,delay);
	}
	GPIO_SetBits(GPIOB, GPIO_Pin_12);
}

/**
* @brief	蜂鸣器简单的控制接口
* @param[in]  unsigned int delay	延时一段时间,单位ms,节拍时长
* @param[in]  unsigned int	beep_freq	蜂鸣器的发声频率，音调
* @return   none 
*/
void hw_platform_beep_ctrl(unsigned short delay,unsigned int beep_freq)
{
	int i;
	for (i = 0; i < (delay*beep_freq)/2000;i++)
	{
		GPIO_SetBits(GPIOB, GPIO_Pin_5);
		delay_us(1000000/beep_freq);
		//delay_us(100);
		GPIO_ResetBits(GPIOB, GPIO_Pin_5);
		delay_us(1000000/beep_freq);
		//delay_us(400);
	}
}

/**
* @brief	蜂鸣器与Motor同时控制接口
* @param[in]  unsigned int delay	延时一段时间,单位ms,节拍时长
* @param[in]  unsigned int	beep_freq	蜂鸣器的发声频率，音调
* @return   none 
*/
void hw_platform_beep_motor_ctrl(unsigned short delay,unsigned int beep_freq)
{
	int i;
	GPIO_SetBits(GPIOA, GPIO_Pin_7);
	for (i = 0; i < (delay*beep_freq)/2000;i++)
	{
		GPIO_SetBits(GPIOB, GPIO_Pin_5);
		delay_us(1000000/beep_freq);
		GPIO_ResetBits(GPIOB, GPIO_Pin_5);
		delay_us(1000000/beep_freq);
	}
	GPIO_ResetBits(GPIOA, GPIO_Pin_7);
}



/**
 * @brief 利用时基模块提供的定时器接口实现LED闪烁
*/
static void led_red_blink_timer_hook(void)
{
	current_led_state ^= LED_RED_MASK;
	hw_platform_led_ctrl(LED_RED,current_led_state & LED_RED_MASK);
}

static void led_blue_blink_timer_hook(void)
{
	current_led_state ^= LED_BLUE_MASK;
	hw_platform_led_ctrl(LED_BLUE,current_led_state & LED_BLUE_MASK);
}

static void led_green_blink_timer_hook(void)
{
	current_led_state ^= LED_GREEN_MASK;
	hw_platform_led_ctrl(LED_GREEN,current_led_state & LED_GREEN_MASK);
}

static void led_yellow_blink_timer_hook(void)
{
	current_led_state ^= LED_YELLOW_MASK;
	hw_platform_led_ctrl(LED_YELLOW,current_led_state & LED_YELLOW_MASK);
}

/**
 * @brief 开始LED闪烁指示
 * @param[in] unsigned int		led		
 * @param[in] unsigned short	delay	闪烁的时间间隔，也就是闪烁频率,单位10ms
 * @note 注意此接口可以让几个LED同时按照各自不同的频率闪烁
*/
void hw_platform_start_led_blink(unsigned int led,unsigned short delay)
{
	int ret;
	hw_platform_led_ctrl(led,1);
	if (led == LED_RED)
	{
		if (current_led_state & LED_RED_ON_MASK)
		{
			current_led_state |= LED_RED_MASK;
			ret = reset_timer(led_timer_h[0],V_TIMER_MODE_PERIODIC,delay*10,led_red_blink_timer_hook);
			assert(ret == 0);
		}
		else
		{
			current_led_state |= (LED_RED_MASK | LED_RED_ON_MASK);
			led_timer_h[0] = start_timer(V_TIMER_MODE_PERIODIC,delay*10,led_red_blink_timer_hook);
			assert(led_timer_h[0] != 0);
		}
	}
	else if (led == LED_BLUE)
	{
		if (current_led_state & LED_BLUE_ON_MASK)
		{
			current_led_state |= LED_BLUE_MASK;
			ret = reset_timer(led_timer_h[1],V_TIMER_MODE_PERIODIC,delay*10,led_blue_blink_timer_hook);
			assert(ret == 0);
		}
		else
		{
			current_led_state |= (LED_BLUE_MASK | LED_BLUE_ON_MASK);
			led_timer_h[1] = start_timer(V_TIMER_MODE_PERIODIC,delay*10,led_blue_blink_timer_hook);
			assert(led_timer_h[1] != 0);
		}
	}
	else if (led == LED_GREEN)
	{
		if (current_led_state & LED_GREEN_ON_MASK)
		{
			current_led_state |= LED_GREEN_MASK;
			ret = reset_timer(led_timer_h[2],V_TIMER_MODE_PERIODIC,delay*10,led_green_blink_timer_hook);
			assert(ret == 0);
		}
		else
		{
			current_led_state |= (LED_GREEN_MASK | LED_GREEN_ON_MASK);
			led_timer_h[2] = start_timer(V_TIMER_MODE_PERIODIC,delay*10,led_green_blink_timer_hook);
			assert(led_timer_h[2] != 0);
		}
	}
	else
	{
		if (current_led_state & LED_YELLOW_ON_MASK)
		{
			current_led_state |= LED_YELLOW_MASK;
			ret = reset_timer(led_timer_h[3],V_TIMER_MODE_PERIODIC,delay*10,led_yellow_blink_timer_hook);
			assert(ret == 0);
		}
		else
		{
			current_led_state |= (LED_YELLOW_MASK | LED_YELLOW_ON_MASK);
			led_timer_h[3] = start_timer(V_TIMER_MODE_PERIODIC,delay*10,led_yellow_blink_timer_hook);
			assert(led_timer_h[3] != 0);
		}
	}
}

/**
 * @brief 关闭某一个在闪烁的LED
*/
void hw_platform_stop_led_blink(unsigned int led)
{
	int ret;
	if (led == LED_RED)
	{
		hw_platform_led_ctrl(LED_RED,0);
		if (current_led_state & LED_RED_ON_MASK)
		{
			current_led_state &= ~LED_RED_MASK;
			current_led_state &= ~LED_RED_ON_MASK;
			ret = stop_timer(led_timer_h[0]);
			assert(ret == 0);
		}
	}
	else if (led == LED_BLUE)
	{
		hw_platform_led_ctrl(LED_BLUE,0);
		if (current_led_state & LED_BLUE_ON_MASK)
		{
			current_led_state &= ~LED_BLUE_MASK;
			current_led_state &= ~LED_BLUE_ON_MASK;
			ret = stop_timer(led_timer_h[1]);
			assert(ret == 0);
		}
	}
	else if (led == LED_GREEN)
	{
		hw_platform_led_ctrl(LED_GREEN,0);
		if (current_led_state & LED_GREEN_ON_MASK)
		{
			current_led_state &= ~LED_GREEN_MASK;
			current_led_state &= ~LED_GREEN_ON_MASK;
			ret = stop_timer(led_timer_h[2]);
			assert(ret == 0);
		}
	}
	else
	{
		hw_platform_led_ctrl(LED_YELLOW,0);
		if (current_led_state & LED_YELLOW_ON_MASK)
		{
			current_led_state &= ~LED_YELLOW_MASK;
			current_led_state &= ~LED_YELLOW_ON_MASK;
			ret = stop_timer(led_timer_h[3]);
			assert(ret == 0);
		}
	}
}

/**
 * @brief 调试IO
*/
void hw_platform_trip_io(void)
{
	GPIO_ResetBits(GPIOB, GPIO_Pin_8);
	GPIO_SetBits(GPIOB, GPIO_Pin_8);
}


//测试LED的闪烁接口
void hw_platform_led_blink_test(void)
{
	hw_platform_start_led_blink(LED_RED,6);
	OSTimeDlyHMSM(0,0,10,0);
	hw_platform_start_led_blink(LED_BLUE,20);
	OSTimeDlyHMSM(0,0,10,0);
	hw_platform_start_led_blink(LED_GREEN,50);
	OSTimeDlyHMSM(0,0,10,0);
	hw_platform_start_led_blink(LED_YELLOW,300);

	OSTimeDlyHMSM(0,0,10,0);

	hw_platform_stop_led_blink(LED_RED);

	OSTimeDlyHMSM(0,0,10,0);

	hw_platform_stop_led_blink(LED_BLUE);

	OSTimeDlyHMSM(0,0,10,0);

	hw_platform_stop_led_blink(LED_GREEN);

	OSTimeDlyHMSM(0,0,10,0);

	StartDelay(5000);

	while (DelayIsEnd()==0);

	hw_platform_stop_led_blink(LED_YELLOW);

}
