joe3501/H520B/(commit log)

2015-08-26 hthe first commit to the master
    [H520B V1.00.pcb, H520B V1.00.sch, bt-PCB-150803.dwg, bt-PCB-150817.dwg, bt-PCB-150821.dwg, bt-PCB-150822.dwg]
2015-08-27 add a document Doc/BT Pocket功能说明.doc
2015-09-09 add demoboard sch and pcb layout
    [H520B Demoboard V1.0 BOM.xlsx, H520B V1.00.pcb, H520B V1.00.sch]
2015-09-15 add a new bsp drivers and fix so much bugs
    [HJ5000_scanner.c, hw_platform.c, hw_platform.h, keypad.c, keypad.h]
2015-09-19 Scanner driver ok! WBTDS01 driver NG!
2015-09-23 BT HID mode OK ,USB HID mode OK, soft timer list todo...!
2015-09-25 almost ok,but the lowpower mode bug need to fix!
    [Terminal_Para.c, Terminal_Para.h, app.c, hw_platform.c, hw_platform.h, keypad.c]
2015-09-26 modify the keypad driver: delete Reset KEY reference code!
    [H520B Demoboard V1.0 BOM.xlsx, H520B V1.00.sch]
2015-09-28 record module refactoring: delete the spi falsh fatfs, base on my spi flash record_mod module,the last 1M spi flash size for U Disk which used for app upgrade!
2015-09-29 fix the bug in the record_m.c
    [HJ5000_scanner.c, Terminal_Para_m.c, app.c, keypad.c, main.c, record_m.c]
2015-10-10 add a new BT Module(BT816) driver and datasheet
    [H520B V1.00.sch]
2015-10-12 BT861 datasheet update,and the driver update too!
2015-10-13 update BT816 driver, modify BT816_Reset() functiongit add *!
2016-01-25 fix the bt816 driver bug
    [H520B V1.00.pcb, H520B V1.00.sch, H520B V1.10.sch, H520B_V100.pcb, bt-PCB-ZP-151104.dwg, bt-pcb-M2-151204.dwg, bt-pcb-hj5000_M3-151204.dwg]
2016-01-29 fix some bug
    [H520B V1.10.sch, 测试列表.xlsx]
